RenzoDaal/PressureMat/(list of files, cad)

Other CAD files:
MeetMat Trim.f3d
