RenzoDaal/PressureMat/Wiring Diagram.png

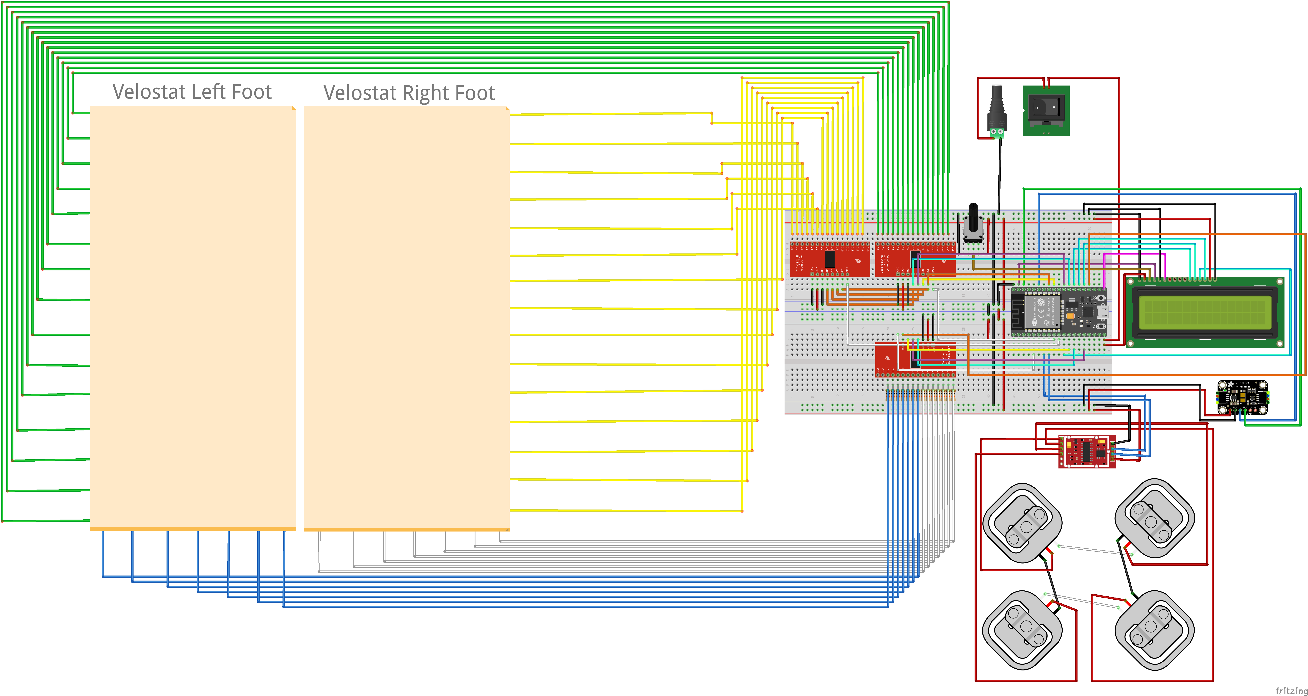
Wiring Diagram.png
