RenzoDaal/PressureMat/globals.h

//==========VL53L1X=============//
#include "SparkFun_VL53L1X.h"
#include <Wire.h>

SFEVL53L1X distanceSensor;
constexpr int TIMING_BUDGET_MS = 200;
constexpr int SAMPLES_PER_CYCLE = 20;
constexpr int DEVIATION_THRESHOLD_CM = 15;
constexpr float acceptablePercentage = 0.3;
//==============================//

//===========HX711==============//
#include "HX711.h"
#define DT 32
#define SCK 33

HX711 scale;
float gewicht = 0;
//==============================//

//=========VELOSTAT=============//
const int rowMux[4] = {16, 17, 18, 19};
const int rowSigL = 25;
const int rowSigR = 26;
const int colMux[4] = {12, 13, 14, 15};
const int colSig = 34;

const int samples = 10;
//==============================//

//============LCD===============//
#include <LiquidCrystal.h>

LiquidCrystal lcd(23, 5, 4, 2, 27, 0);
//==============================//

//============BLE===============//
#include <BLE2902.h>
#include <BLEDevice.h>
#include <BLEServer.h>
#include <BLEUtils.h>

#define SERVICE_UUID "6e400001-b5a3-f393-e0a9-e50e24dcca9e"
#define CHARACTERISTIC_TX "6e400003-b5a3-f393-e0a9-e50e24dcca9e"
#define CHARACTERISTIC_RX "6e400002-b5a3-f393-e0a9-e50e24dcca9e"

BLEServer* pServer = nullptr;
BLECharacteristic* pTxCharacteristic;
BLECharacteristic* pRxCharacteristic;
bool deviceConnected = false;
bool awaitingResponse = false;
bool resultsSend = false;
//==============================//

enum State
{
  PAIRING,
  CONNECTED,
  START,
  DISAPPROVED,
  APPROVED,
  RESULTS
};
State currentState = PAIRING;

bool timerStarts = false;
bool timerCancel = false;
bool timerFinish = false;

//====VELOSTAT_BASELINE_NO_WEIGHT=====//
int baselineLeft[15][7] = {
    {1212, 1035,  963,  954,  974,  885,  806},
    {2278, 2201, 2253, 2298, 2241, 2163, 2144},
    {2092, 1955, 1875, 1842, 1839, 1732, 1576},
    { 975,  796,  719,  687,  684,  617,  569},
    {1901, 1926, 1969, 1996, 2004, 1946, 1875},
    { 846,  817,  801,  858,  914,  790,  733},
    {2587, 2602, 2599, 2531, 2466, 2211, 2020},
    {1486, 1336, 1315, 1327, 1248, 1109, 1009},
    {1908, 1987, 1970, 1922, 1869, 1650, 1519},
    {1733, 1673, 1671, 1697, 1881, 1937, 1744},
    {1276, 1105, 1045, 1044, 1109, 1165, 1147},
    {2433, 2371, 2292, 2269, 2333, 2221, 2092},
    {1840, 1659, 1483, 1411, 1392, 1274, 1169},
    {1966, 1882, 1760, 1761, 1840, 1615, 1469},
    {1191, 1174, 1181, 1184, 1206, 1220, 1391}
};
int baselineRight[15][7] = {
    { 792,  690,  667,  659,  683,  675,  624},
    {1296, 1299, 1306, 1321, 1392, 1715, 1843},
    {1804, 1800, 1791, 1840, 1864, 1978, 1762},
    {1136, 1139, 1161, 1212, 1324, 1284, 1129},
    { 297,  226,  207,  197,  196,  181,  149},
    {2290, 2310, 2337, 2375, 2382, 2296, 2040},
    {1694, 1739, 1861, 1853, 1754, 1691, 1501},
    {2881, 2863, 2865, 2806, 2738, 2670, 2393},
    {2736, 2744, 2769, 2681, 2627, 2479, 2231},
    {2963, 2951, 2943, 2892, 2852, 2738, 2459},
    {1292, 1385, 1308, 1264, 1286, 1334, 1295},
    {2704, 2728, 2716, 2638, 2629, 2480, 2224},
    {2548, 2556, 2559, 2623, 2673, 2417, 2161},
    {1492, 1267, 1186, 1156, 1143, 1090,  970},
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
    {3432, 3477, 3523, 3519, 3492, 3470, 3488},
    {3518, 3570, 3597, 3604, 3582, 3542, 3548},
    {3532, 3584, 3603, 3589, 3589, 3532, 3538},
    {3423, 3448, 3486, 3473, 3470, 3440, 3440},
    {3012, 3008, 3022, 3032, 3074, 3045, 3013}
};
//====================================//
