RenzoDaal/PressureMat/(commit log)

2025-06-11 Sensor Onderzoek
2025-06-11 3d bestanden
    [MeetMat Trim.f3d]
